JacekGreniger/fpga-sdr-platform/boards.jpg

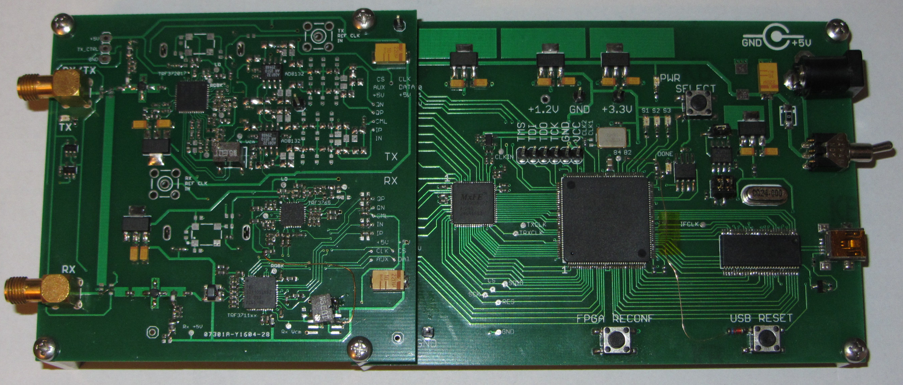
boards.jpg
