JacekGreniger/fpga-sdr-platform/(list of files, cad)

Other CAD files:
fw/USBJmpTb.OBJ
