JacekGreniger/fpga-sdr-platform/hw/fsdr.brd

## EAGLE design hw/fsdr.brd (2014-01-04)

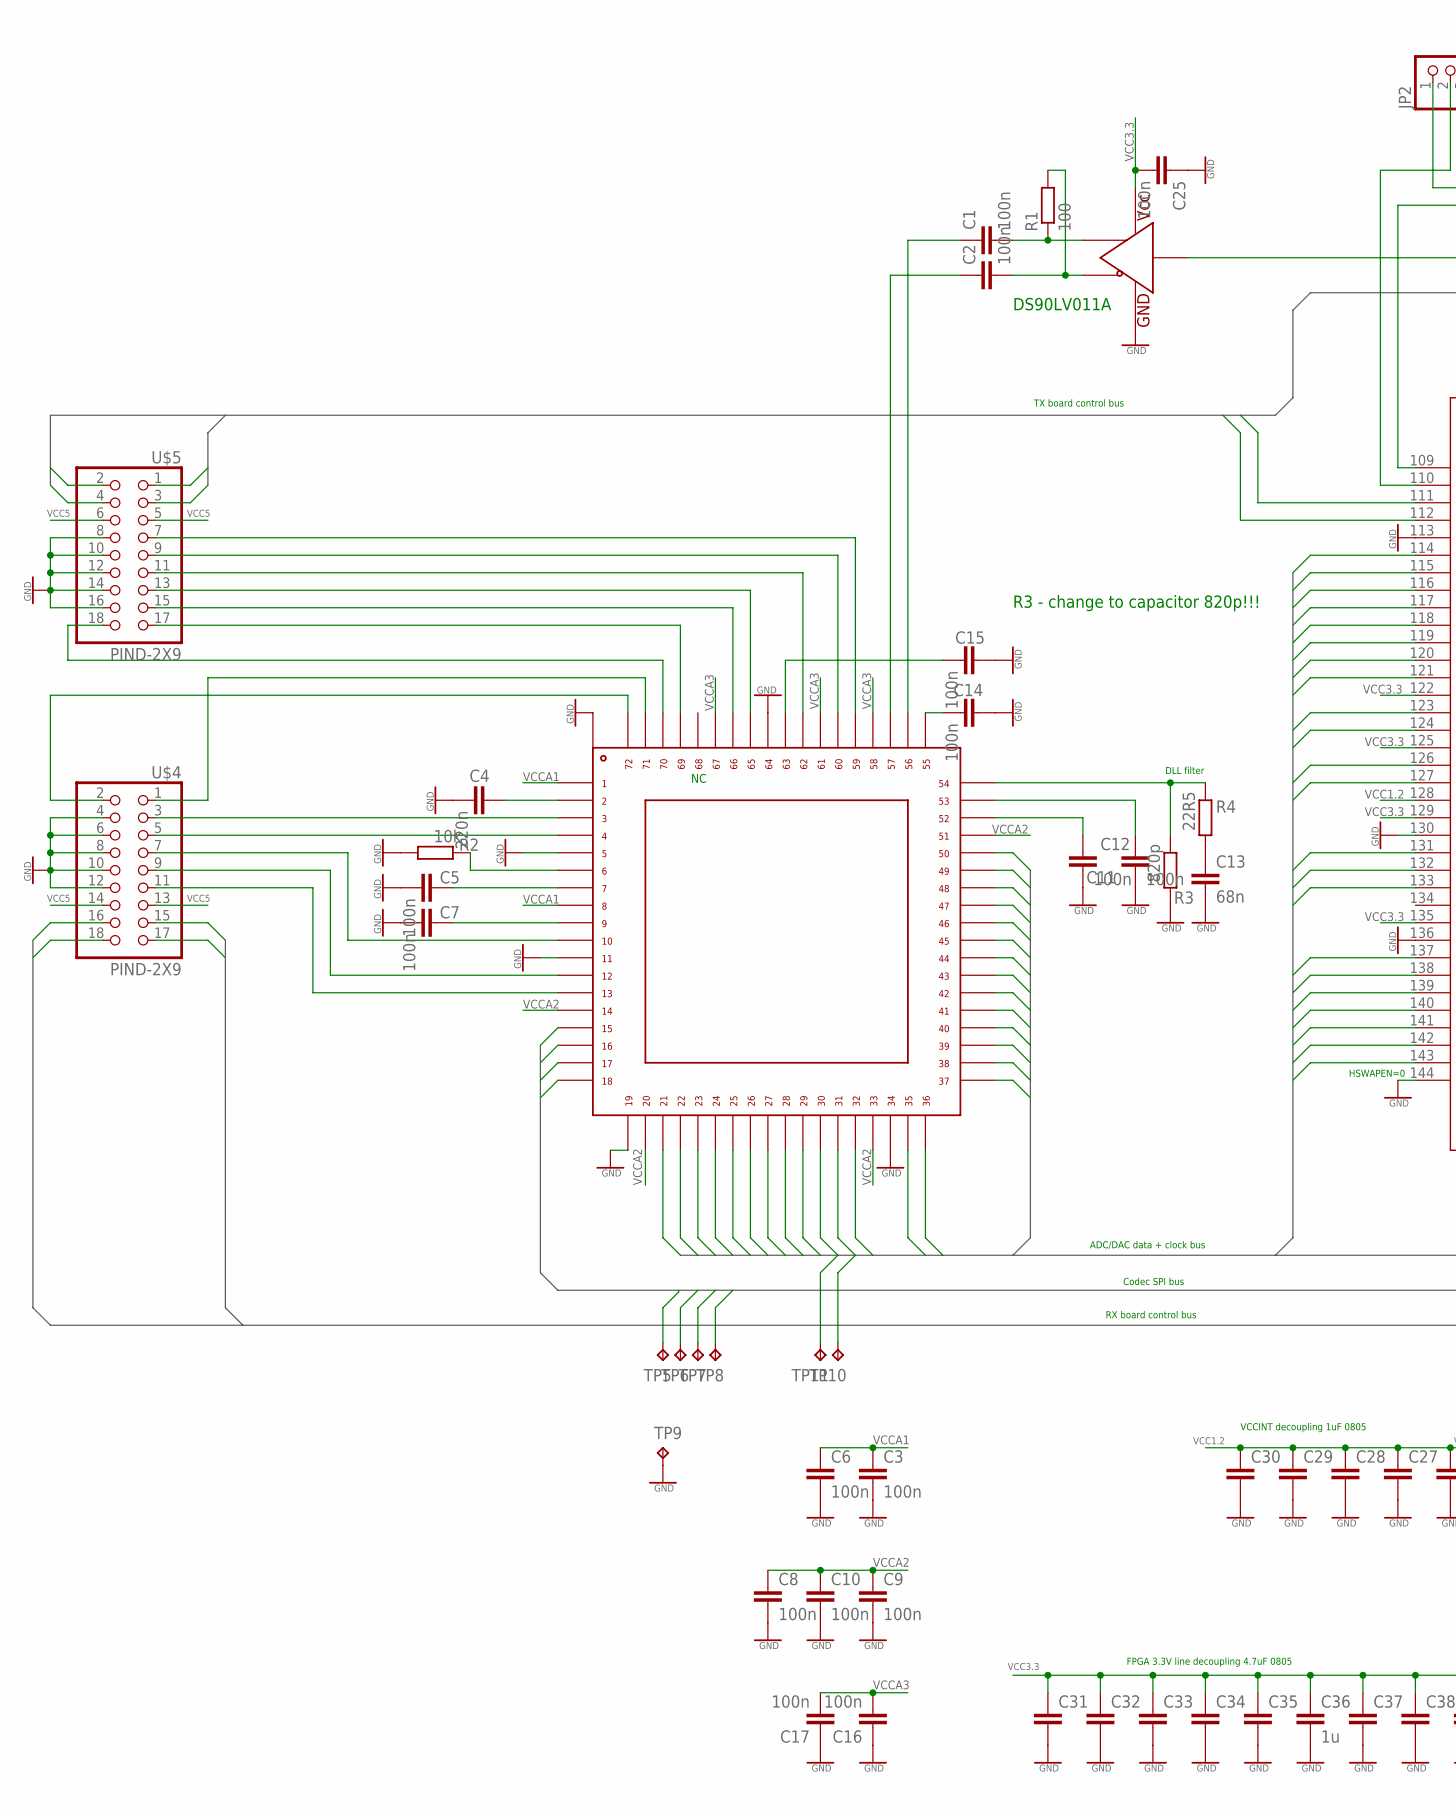
[picture p2: schematic fsdr.sch, sheet 1, part in row 1, column 1]

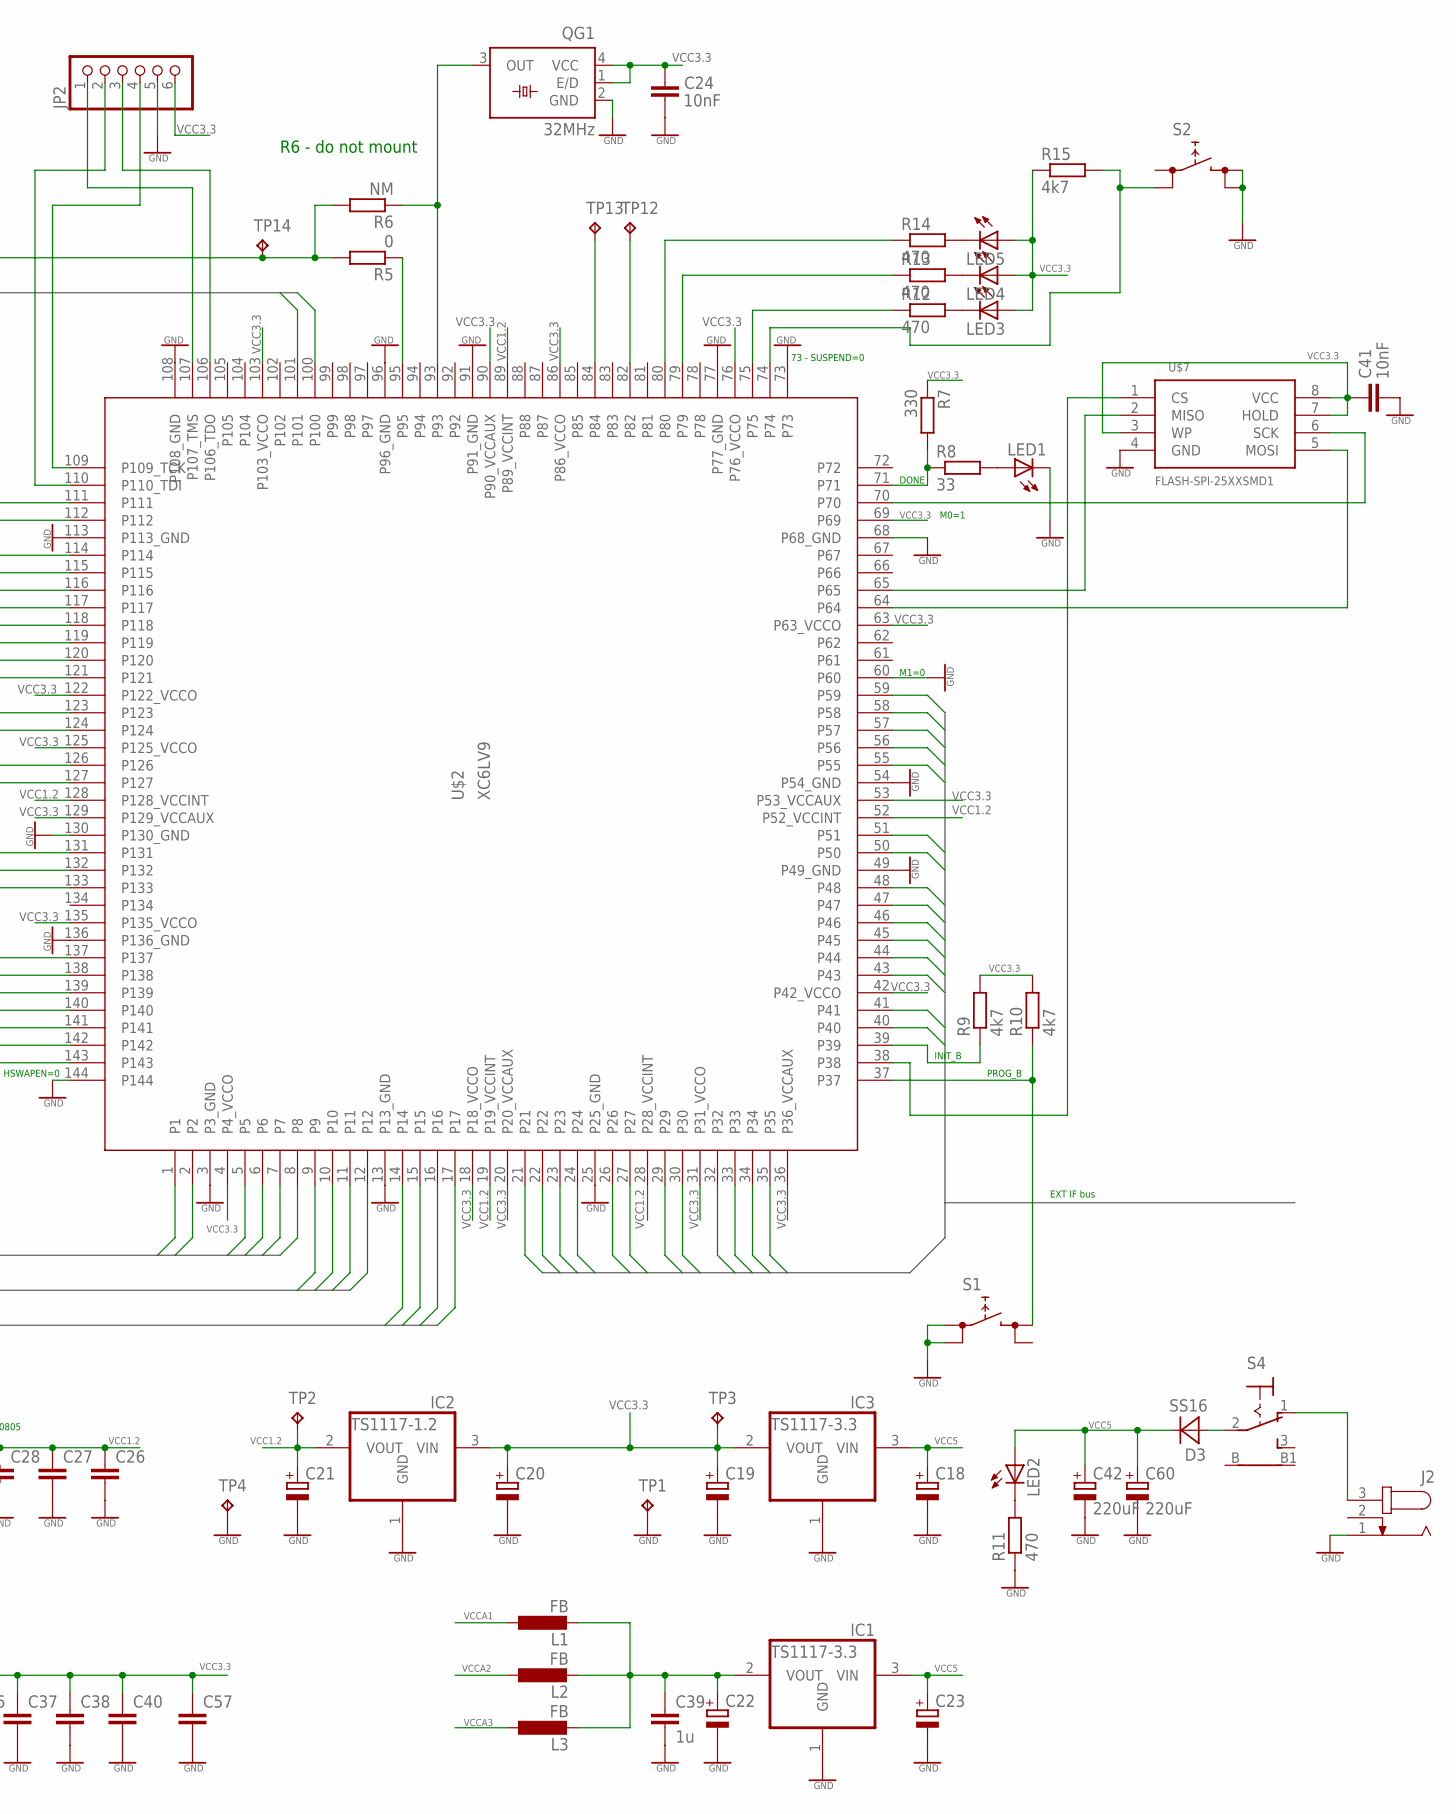
[picture p3: schematic fsdr.sch, sheet 1, part in row 1, column 2]

Parts:
C1, C2, C3, C5, C6, C7, C8, C9, C10, C11, C12, C14, C15, C16, C17, C25: 100n; C0402
C4: 220n; C0402
C13: 68n; C0402
C18, C19, C20, C21, C22, C23: CPOL-EUSMCA; SMC_A
C24, C41: 10nF; C0402
C26, C27, C28, C29, C30, C31, C32, C33, C34, C35, C37, C38, C40, C57: C-EUC0805; C0805
C36, C39: 1u; C0805
C42, C60: 220uF; SMC_D
D3: SS16; SMA
IC1, IC3: TS1117-3.3; SOT223
IC2: TS1117-1.2; SOT223
J2: JACK-PLUG; SPC4078-NOSLOT
JP2: PINHD-1X6; 1X06
L1, L2, L3: FB; C0603
LED1, LED2, LED3, LED4, LED5: LEDSML0805; SML0805
QG1: 32MHz; SM77H
R1: 100; R0402
R2: 10k; R0402
R3: 820p; R0402
R4: 22R5; R0402
R5: 0; R0402
R6: NM; R0402
R7: 330; R0402
R8: 33; R0402
R9, R10, R15: 4k7; R0402
R11, R12, R13, R14: 470; R0402
S1, S2: SKHMPSE010; SKHMPXE010
S4: 9070-1W
TP1, TP2, TP3, TP4: TPPAD1-13; P1-13
TP5, TP6, TP7, TP8, TP9, TP10, TP11, TP12, TP13, TP14: TPB1,27; B1,27
U$1: AD9963; LFCSP72
U$2: XC6LV9; TQFP144
U$3: DS90LV011a; SOT23-5L
U$4, U$5: PIND-2X9; 2X9SMD
U$7: FLASH-SPI-25XXSMD1; SO08-EIAJ

Connections:
CS: TP7.TP, U$1.P$17, U$2.10
GND: C3.2, C4.2, C5.2, C6.2, C7.2, C8.2, C9.2, C10.2, C11.2, C12.2, C13.2, C14.1, C15.1, C16.1, C17.1, C18.-, C19.-, C20.-, C21.-, C22.-, C23.-, C24.1, C25.1, C26.2, C27.2, C28.2, C29.2, C30.2, C31.2, C32.2, C33.2, C34.2, C35.2, C36.2, C37.2, C38.2, C39.2, C40.2, C41.1, C42.-, C57.2, C60.-, IC1.1 (GND), IC2.1 (GND), IC3.1 (GND), J2.1, JP2.5, LED1.C, QG1.2 (GND), R2.2, R3.2, R11.1, S1.1 (1.1), S1.2 (1.2), S2.3 (2.1), S2.4 (2.2), TP1.TP, TP4.TP, TP9.TP, U$1.P$5, U$1.P$11, U$1.P$19, U$1.P$34, U$1.P$64, U$1.P$73_PAD, U$2.3 (P3_GND), U$2.13 (P13_GND), U$2.25 (P25_GND), U$2.49 (P49_GND), U$2.54 (P54_GND), U$2.60, U$2.68 (P68_GND), U$2.73, U$2.77 (P77_GND), U$2.91 (P91_GND), U$2.96 (P96_GND), U$2.108 (P108_GND), U$2.113 (P113_GND), U$2.130 (P130_GND), U$2.136 (P136_GND), U$2.144, U$3.2 (GND), U$4.4, U$4.6, U$4.8, U$4.10, U$4.12, U$5.8, U$5.10, U$5.12, U$5.14, U$5.16, U$7.4 (GND); also elsewhere on the board
unnamed: R7.2, R8.1, U$2.71
unnamed: QG1.3 (OUT), R6.1, U$2.93
unnamed: LED1.A, R8.2
unnamed: JP2.1, U$2.107 (P107_TMS)
unnamed: JP2.3, U$2.106 (P106_TDO)
unnamed: JP2.4, U$2.109 (P109_TCK)
unnamed: JP2.2, U$2.110 (P110_TDI)
unnamed: R10.1, S1.3 (2.1), U$2.37
unnamed: U$1.P$3, U$4.3
unnamed: U$1.P$4, U$4.5
unnamed: U$1.P$10, U$4.7
unnamed: U$1.P$12, U$4.9
unnamed: C7.1, U$1.P$9
unnamed: U$1.P$72, U$4.2
unnamed: U$1.P$71, U$4.1
unnamed: U$1.P$70, U$5.18
unnamed: U$1.P$69, U$5.17
unnamed: U$1.P$66, U$5.15
unnamed: U$1.P$65, U$5.13
unnamed: U$1.P$62, U$5.11
unnamed: U$1.P$60, U$5.9
unnamed: U$1.P$59, U$5.7
unnamed: C1.2, R1.1, U$3.4 (OUT)
unnamed: C2.2, R1.2, U$3.3 (/OUT)
unnamed: C2.1, U$1.P$57
unnamed: C13.1, R4.2
unnamed: C1.1, U$1.P$56
unnamed: R9.1, U$2.39
unnamed: U$1.P$13, U$4.11
unnamed: R2.1, U$1.P$6
unnamed: C5.1, U$1.P$7
unnamed: C4.1, U$1.P$2
unnamed: C14.2, U$1.P$55
unnamed: C15.2, U$1.P$63
unnamed: R3.1, R4.1, U$1.P$54
unnamed: C12.1, U$1.P$53
unnamed: C11.1, U$1.P$52
unnamed: R5.2, R6.2, TP14.TP, U$3.5 (IN)
unnamed: R5.1, U$2.95
unnamed: TP12.TP, U$2.82
unnamed: TP13.TP, U$2.84
unnamed: D3.A, S4.2
unnamed: LED2.C, R11.2
unnamed: C22.+, C39.1, IC1.2 (VOUT), L1.2, L2.2, L3.2
unnamed: J2.3, S4.1 (O)
unnamed: U$2.38, U$7.1 (CS)
unnamed: U$2.64, U$7.5 (MOSI)
unnamed: U$2.70, U$7.6 (SCK)
unnamed: U$2.65, U$7.2 (MISO)
unnamed: R12.1, U$2.75
unnamed: LED3.C, R12.2
unnamed: LED4.C, R13.2
unnamed: LED5.C, R14.2
unnamed: R13.1, U$2.79
unnamed: R14.1, U$2.80
unnamed: R15.2, S2.2 (1.2), U$2.74
P14: U$2.14, U$4.16
P15: U$2.15, U$4.15
P16: U$2.16, U$4.18
P17: U$2.17, U$4.17
P21: U$2.21; also elsewhere on the board
P22: U$2.22; also elsewhere on the board
P23: U$2.23; also elsewhere on the board
P24: U$2.24; also elsewhere on the board
P26: U$2.26; also elsewhere on the board
P27: U$2.27; also elsewhere on the board
P29: U$2.29; also elsewhere on the board
P30: U$2.30; also elsewhere on the board
P32: U$2.32; also elsewhere on the board
P33: U$2.33; also elsewhere on the board
P34: U$2.34; also elsewhere on the board
P35: U$2.35; also elsewhere on the board
P40: U$2.40; also elsewhere on the board
P41: U$2.41; also elsewhere on the board
P43: U$2.43; also elsewhere on the board
P44: U$2.44; also elsewhere on the board
P45: U$2.45; also elsewhere on the board
P46: U$2.46; also elsewhere on the board
P47: U$2.47; also elsewhere on the board
P48: U$2.48; also elsewhere on the board
P50: U$2.50; also elsewhere on the board
P51: U$2.51; also elsewhere on the board
P55: U$2.55; also elsewhere on the board
P56: U$2.56; also elsewhere on the board
P57: U$2.57; also elsewhere on the board
P58: U$2.58; also elsewhere on the board
P59: U$2.59; also elsewhere on the board
P61: U$2.61
P85: U$2.85
P88: U$2.88
P98: U$2.98
P100: U$2.100, U$5.2
P101: U$2.101, U$5.1
P111: U$2.111, U$5.4
P112: U$2.112, U$5.3
RES: TP5.TP, U$1.P$15, U$2.12
SCK: TP6.TP, U$1.P$16, U$2.11
SD: TP8.TP, U$1.P$18, U$2.9
TRXCLK: TP11.TP, U$1.P$36, U$2.133
TRXD0: U$1.P$32, U$2.138
TRXD1: U$1.P$31, U$2.139
TRXD2: U$1.P$30, U$2.140
TRXD3: U$1.P$29, U$2.141
TRXD4: U$1.P$28, U$2.142
TRXD5: U$1.P$27, U$2.143
TRXD6: U$1.P$26, U$2.1
TRXD7: U$1.P$25, U$2.2
TRXD8: U$1.P$24, U$2.5
TRXD9: U$1.P$23, U$2.6
TRXD10: U$1.P$22, U$2.7
TRXD11: U$1.P$21, U$2.8
TRXIQ: U$1.P$35, U$2.137
TXCLK: TP10.TP, U$1.P$37, U$2.132
TXD0: U$1.P$50, U$2.114
TXD1: U$1.P$49, U$2.115
TXD2: U$1.P$48, U$2.116
TXD3: U$1.P$47, U$2.117
TXD4: U$1.P$46, U$2.118
TXD5: U$1.P$45, U$2.119
TXD6: U$1.P$44, U$2.120
TXD7: U$1.P$43, U$2.121
TXD8: U$1.P$42, U$2.123
TXD9: U$1.P$41, U$2.124
TXD10: U$1.P$40, U$2.126
TXD11: U$1.P$39, U$2.127
TXIQ: U$1.P$38, U$2.131
VCC1.2: C21.+, C26.1, C27.1, C28.1, C29.1, C30.1, IC2.2 (VOUT), TP2.TP, U$2.19 (P19_VCCINT), U$2.28 (P28_VCCINT), U$2.52 (P52_VCCINT), U$2.89 (P89_VCCINT), U$2.128 (P128_VCCINT)
VCC3.3: C19.+, C20.+, C24.2, C25.2, C31.1, C32.1, C33.1, C34.1, C35.1, C36.1, C37.1, C38.1, C40.1, C41.2, C57.1, IC2.3 (VIN), IC3.2 (VOUT), JP2.6, LED3.A, LED4.A, LED5.A, QG1.1 (E/D), QG1.4 (VCC), R7.1, R9.2, R10.2, R15.1, TP3.TP, U$2.4 (P4_VCCO), U$2.18 (P18_VCCO), U$2.20 (P20_VCCAUX), U$2.31 (P31_VCCO), U$2.36 (P36_VCCAUX), U$2.42 (P42_VCCO), U$2.53 (P53_VCCAUX), U$2.63 (P63_VCCO), U$2.69, U$2.76 (P76_VCCO), U$2.86 (P86_VCCO), U$2.90 (P90_VCCAUX), U$2.103 (P103_VCCO), U$2.122 (P122_VCCO), U$2.125 (P125_VCCO), U$2.129 (P129_VCCAUX), U$2.135 (P135_VCCO), U$3.1 (VCC), U$7.3 (WP), U$7.7 (HOLD), U$7.8 (VCC)
VCC5: C18.+, C23.+, C42.+, C60.+, D3.C, IC1.3 (VIN), IC3.3 (VIN), LED2.A, U$4.13, U$4.14, U$5.5, U$5.6; also elsewhere on the board
VCCA1: C3.1, C6.1, L1.1, U$1.P$1, U$1.P$8
VCCA2: C8.1, C9.1, C10.1, L2.1, U$1.P$14, U$1.P$20, U$1.P$33, U$1.P$51
VCCA3: C16.2, C17.2, L3.1, U$1.P$58, U$1.P$61, U$1.P$67

Notes on the sheet:
VCCINT decoupling 1uF 0805
HSWAPEN=0
73 - SUSPEND=0
DONE
M1=0
M0=1
PROG_B
INIT_B
FPGA 3.3V line decoupling 4.7uF 0805
Codec SPI bus
RX board control bus
ADC/DAC data + clock bus
DLL filter
TX board control bus
EXT IF bus
R3 - change to capacitor 820p!!!
R6 - do not mount
DS90LV011A

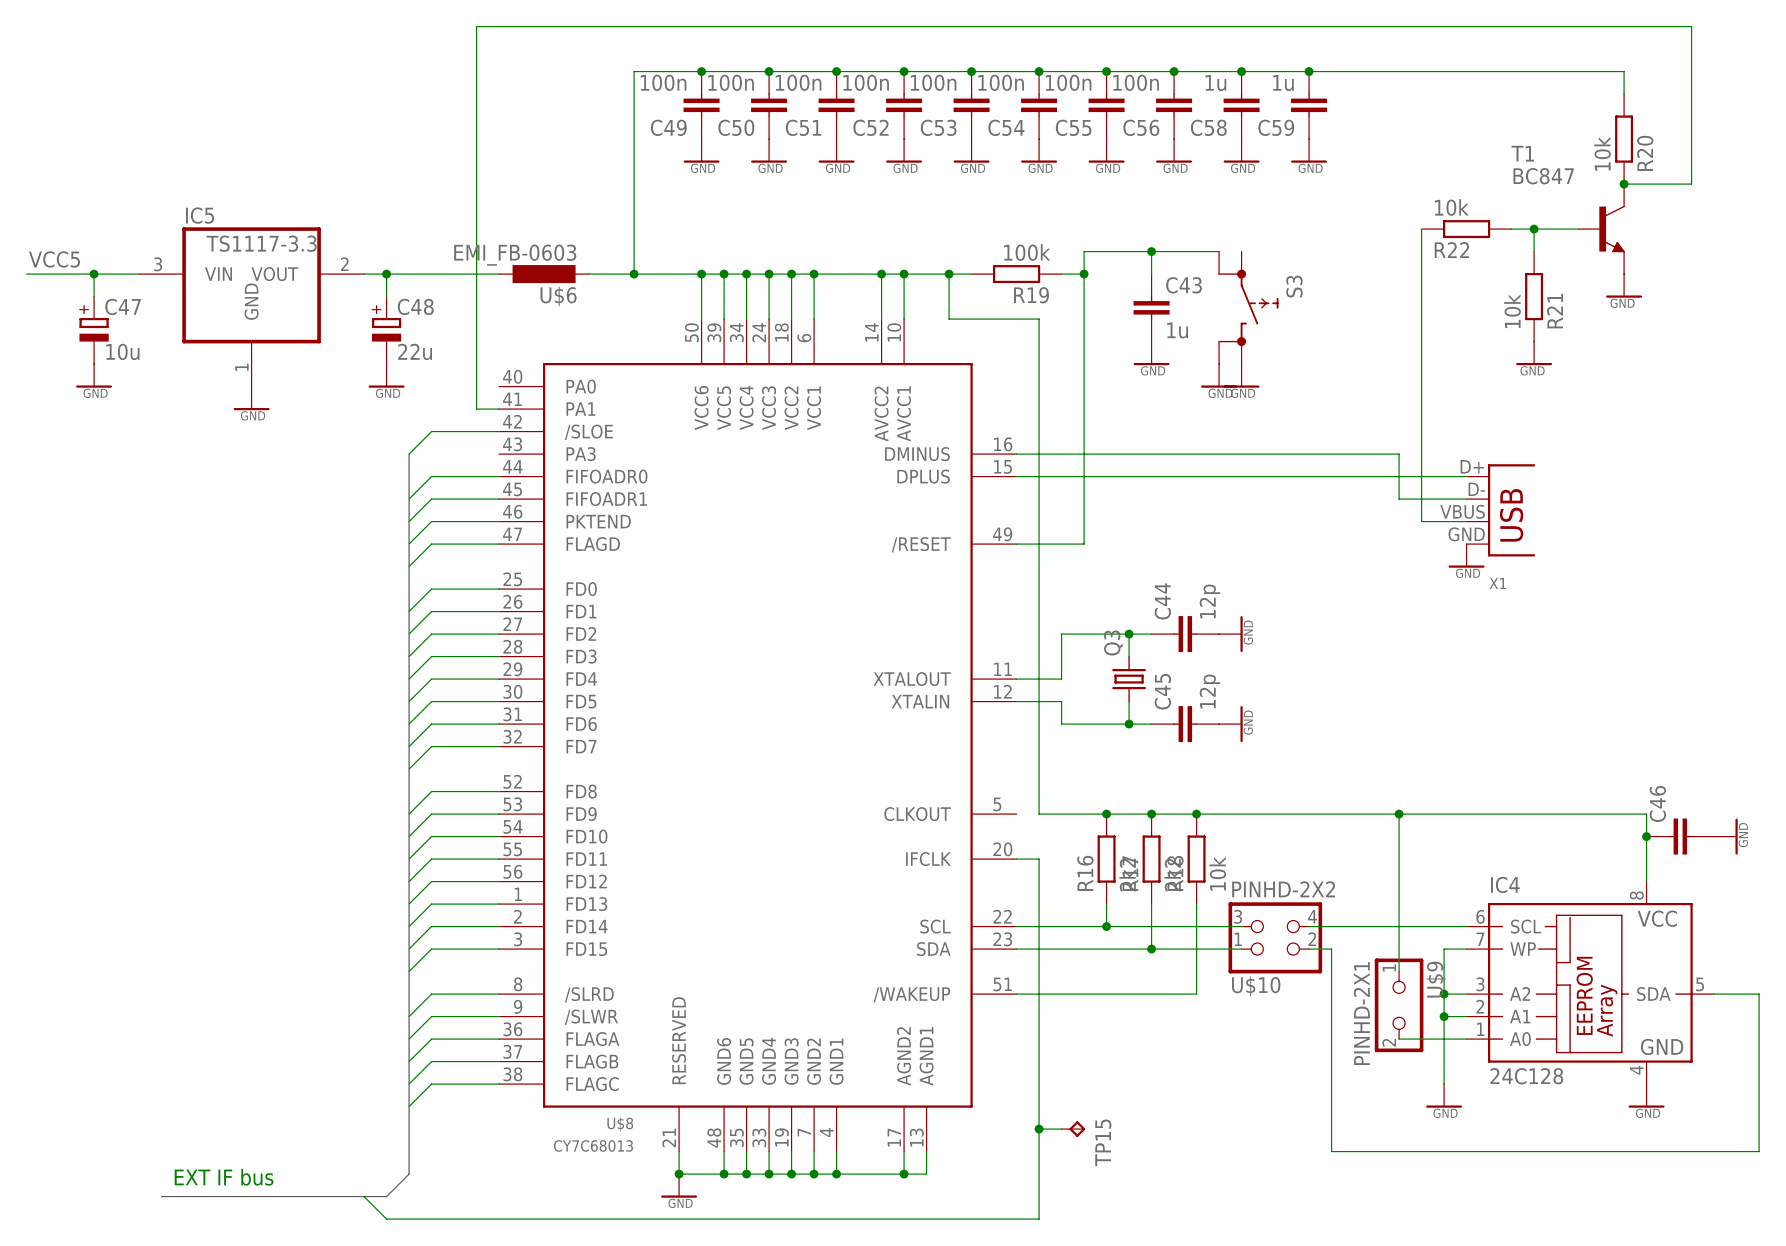
[picture p4: schematic fsdr.sch, sheet 2]

Parts:
C43, C58, C59: 1u; C0402
C44, C45: 12p; C0402
C46: C-EUC0402; C0402
C47: 10u; SMC_A
C48: 22u; SMC_A
C49, C50, C51, C52, C53, C54, C55, C56: 100n; C0402
IC4: 24C128; SO-08
IC5: TS1117-3.3; SOT223
Q3: CRYSTALHC49U-V; HC49U-V
R16, R17: 2k2; R0402
R18, R20, R21, R22: 10k; R0402
R19: 100k; R0402
S3: SKHMPSE010; SKHMPXE010
T1: BC847; SOT23
TP15: TPB1,27; B1,27
U$6: EMI_FB-0603; C0603
U$8: CY7C68013; 56-SSOP
U$9: PINHD-2X1; 2X1SMD
U$10: PINHD-2X2; 2X2SMD
X1: USB-MB-S

Connections:
GND: C43.2, C44.2, C45.2, C46.2, C47.-, C48.-, C49.1, C50.1, C51.1, C52.1, C53.1, C54.1, C55.1, C56.1, C58.1, C59.1, IC4.2 (A1), IC4.3 (A2), IC4.4 (GND), IC4.7 (WP), IC5.1 (GND), R21.1, S3.3 (2.1), S3.4 (2.2), T1.2 (E), U$8.4 (GND1), U$8.7 (GND2), U$8.13 (AGND1), U$8.17 (AGND2), U$8.19 (GND3), U$8.21 (RESERVED), U$8.33 (GND4), U$8.35 (GND5), U$8.48 (GND6), X1.GND; also elsewhere on the board
unnamed: U$8.15 (DPLUS), X1.D+
unnamed: U$8.16 (DMINUS), X1.D-
unnamed: C43.1, R19.1, S3.2 (1.2), U$8.49 (/RESET)
unnamed: R16.1, U$8.22 (SCL), U$10.3
unnamed: IC4.5 (SDA), U$10.2
unnamed: R18.1, U$8.51 (/WAKEUP)
unnamed: C44.1, Q3.2, U$8.11 (XTALOUT)
unnamed: C45.1, Q3.1, U$8.12 (XTALIN)
unnamed: C46.1, C49.2, C50.2, C51.2, C52.2, C53.2, C54.2, C55.2, C56.2, C58.2, C59.2, IC4.8 (VCC), R16.2, R17.2, R18.2, R19.2, R20.2, U$6.2, U$8.6 (VCC1), U$8.10 (AVCC1), U$8.14 (AVCC2), U$8.18 (VCC2), U$8.24 (VCC3), U$8.34 (VCC4), U$8.39 (VCC5), U$8.50 (VCC6), U$9.1
unnamed: IC4.1 (A0), U$9.2
unnamed: C48.+, IC5.2 (VOUT), U$6.1
unnamed: R22.1, X1.VBUS
unnamed: R17.1, U$8.23 (SDA), U$10.1
unnamed: IC4.6 (SCL), U$10.4
unnamed: R20.1, T1.3 (C), U$8.41 (PA1)
unnamed: R21.2, R22.2, T1.1 (B)
P21: U$8.56 (FD12); also elsewhere on the board
P22: U$8.55 (FD11); also elsewhere on the board
P23: U$8.54 (FD10); also elsewhere on the board
P24: U$8.53 (FD9); also elsewhere on the board
P26: U$8.52 (FD8); also elsewhere on the board
P27: U$8.47 (FLAGD); also elsewhere on the board
P29: U$8.46 (PKTEND); also elsewhere on the board
P30: U$8.45 (FIFOADR1); also elsewhere on the board
P32: U$8.44 (FIFOADR0); also elsewhere on the board
P33: U$8.42 (/SLOE); also elsewhere on the board
P34: U$8.38 (FLAGC); also elsewhere on the board
P35: U$8.37 (FLAGB); also elsewhere on the board
P40: U$8.29 (FD4); also elsewhere on the board
P41: U$8.30 (FD5); also elsewhere on the board
P43: U$8.31 (FD6); also elsewhere on the board
P44: U$8.32 (FD7); also elsewhere on the board
P45: U$8.36 (FLAGA); also elsewhere on the board
P46: U$8.27 (FD2); also elsewhere on the board
P47: U$8.28 (FD3); also elsewhere on the board
P48: U$8.26 (FD1); also elsewhere on the board
P50: U$8.25 (FD0); also elsewhere on the board
P51: TP15.TP, U$8.20 (IFCLK); also elsewhere on the board
P55: U$8.9 (/SLWR); also elsewhere on the board
P56: U$8.8 (/SLRD); also elsewhere on the board
P57: U$8.3 (FD15); also elsewhere on the board
P58: U$8.2 (FD14); also elsewhere on the board
P59: U$8.1 (FD13); also elsewhere on the board
VCC5: C47.+, IC5.3 (VIN); also elsewhere on the board

Notes on the sheet:
EXT IF bus

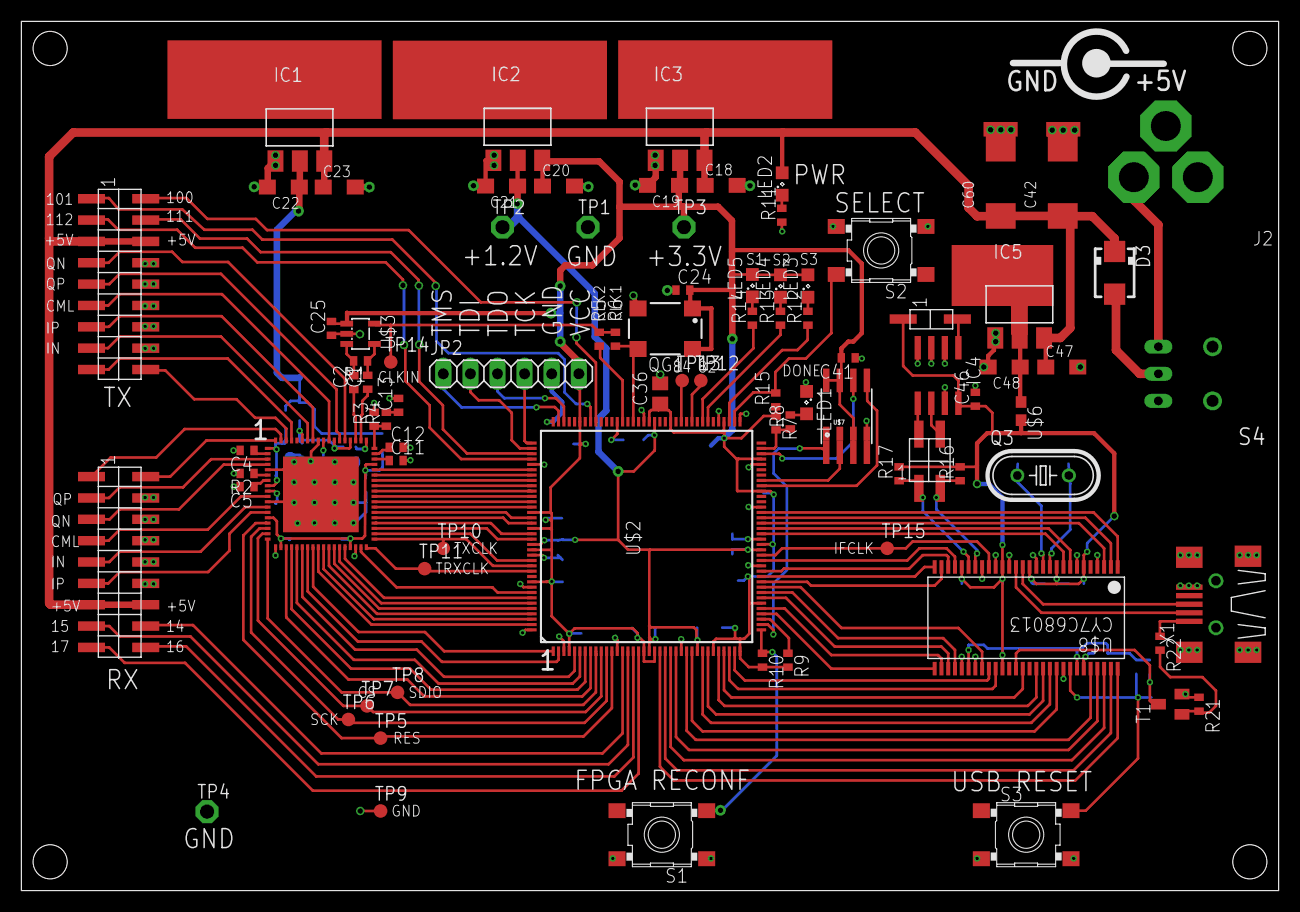
[picture p5: board fsdr.brd from above]

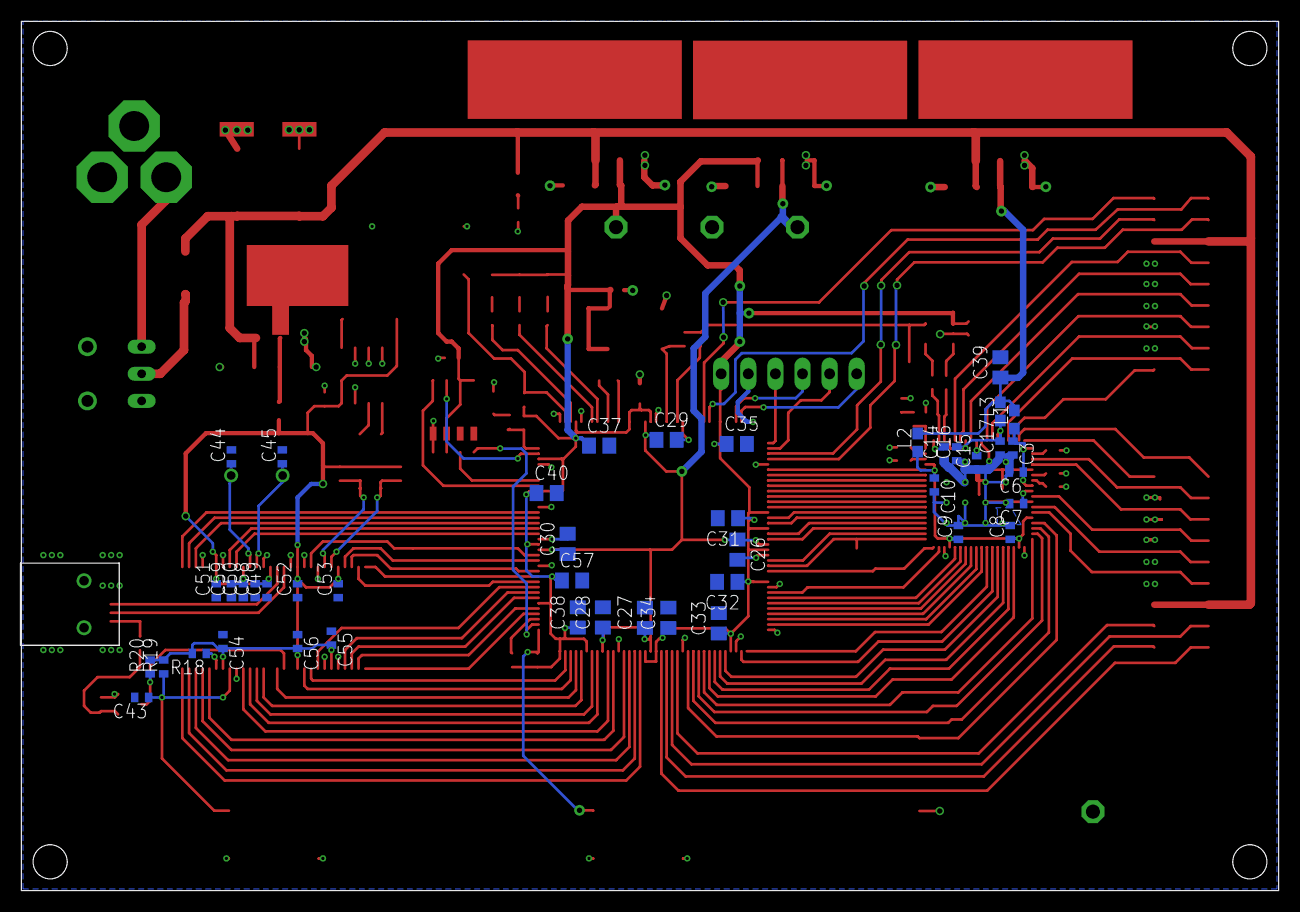
[picture p6: board fsdr.brd from below]

Board: 2 copper layers, 117.8 x 81.4 mm, 131 parts (44 on the bottom side), 146 nets.
