JacekGreniger/fpga-sdr-platform/fw/slave.c

#pragma NOIV                    // Do not generate interrupt vectors
//-----------------------------------------------------------------------------
//   File:      slave.c
//   Contents:  Hooks required to implement USB peripheral function.
//              Code written for FX2 REVE 56-pin and above.
//              This firmware is used to demonstrate FX2 Slave FIF
//              operation.
//   Copyright (c) 2003 Cypress Semiconductor All rights reserved
//-----------------------------------------------------------------------------
#include "fx2.h"
#include "fx2regs.h"
#include "fx2sdly.h"            // SYNCDELAY macro
#include "fsdr.h"

extern BOOL GotSUD;             // Received setup data flag
extern BOOL Sleep;
extern BOOL Rwuen;
extern BOOL Selfpwr;

BYTE Configuration;             // Current configuration
BYTE AlternateSetting;          // Alternate settings

//static WORD xdata LED_Count = 0;

// EZUSB FX2 PORTA = slave fifo enable(s), when IFCFG[1:0]=11
//sbit PA0 = IOA ^ 0;             // alt. func., INT0#
//sbit PA1 = IOA ^ 1;             // alt. func., INT1#
// sbit PA2 = IOA ^ 2;          // is SLOE
//sbit PA3 = IOA ^ 3;             // alt. func., WU2
// sbit PA4 = IOA ^ 4;          // is FIFOADR0
// sbit PA5 = IOA ^ 5;          // is FIFOADR1
// sbit PA6 = IOA ^ 6;          // is PKTEND
// sbit PA7 = IOA ^ 7;          // is FLAGD

// EZUSB FX2 PORTB = FD[7:0], when IFCFG[1:0]=11
// sbit PB0 = IOB ^ 0;
// sbit PB1 = IOB ^ 1;
// sbit PB2 = IOB ^ 2;
// sbit PB3 = IOB ^ 3;
// sbit PB4 = IOB ^ 4;
// sbit PB5 = IOB ^ 5;
// sbit PB6 = IOB ^ 6;
// sbit PB7 = IOB ^ 7;

// EZUSB FX2 PORTD = FD[15:8], when IFCFG[1:0]=11 and WORDWIDE=1
//sbit PD0 = IOD ^ 0;
//sbit PD1 = IOD ^ 1;
//sbit PD2 = IOD ^ 2;
//sbit PD3 = IOD ^ 3;
//sbit PD4 = IOD ^ 4;
//sbit PD5 = IOD ^ 5;
//sbit PD6 = IOD ^ 6;
//sbit PD7 = IOD ^ 7;


BOOL Header_insert = FALSE; // insert header

//-----------------------------------------------------------------------------
// Task Dispatcher hooks
//   The following hooks are called by the task dispatcher.
//-----------------------------------------------------------------------------
void TD_Init( void )
{ 
  CPUCS = 0x12; // CLKSPD[1:0]=10, for 48MHz operation, output CLKOUT driven
 
//  IFCONFIG = 0xE3; // for sync, internal clk, driving IFCLK

  IFCONFIG = 0x03; // use IFCLK pin driven by external logic (5MHz to 48MHz)
// use slave FIFO interface pins driven sync by external master

  // 7 - IFCLKSRC=1   , FIFOs executes on internal clk source 
  // 6 - xMHz=1       , 48MHz operation
  // 5 - IFCLKOE=1    ,Drive IFCLK pin signal at 48MHz
  // 4 - IFCLKPOL=0   , Don't invert IFCLK pin signal from internal clk
  // 3 - ASYNC=0      , master samples synchronous
  // 2 - GSTATE=0     , Don't drive GPIF states out on PORTE[2:0], debug WF
  // 1,0 - IFCFG[1:0]=11, FX2 in slave FIFO mode


  PINFLAGSAB = 0x98; // FLAGA - EP2 Empty flag, FLAGB - EP4 EF
  SYNCDELAY; 
  PINFLAGSCD = 0xEF; // FLAGD - EP6 FULL flag, FLAGC - EP8 FF
  SYNCDELAY; 
  PORTACFG |= 0x80; //PA7 as alternative pin - FLAGD

  // EP2 512 BULK OUT 2x
  SYNCDELAY;                    // see TRM section 15.14
  EP2CFG = 0xA2;                // BUF[1:0]=10 for 2x buffering
  
  // EP6 512 BULK IN 2x
  SYNCDELAY;                    // 
  EP6CFG = 0xE2;                // BUF[1:0]=10 for 2x buffering
  
  // EP4 512 BULK OUT 2x
  SYNCDELAY;                    // see TRM section 15.14
  EP4CFG = 0xA0;                // BUF[1:0]=00 for 4x buffering
  
  // EP6 512 BULK IN 2x
  SYNCDELAY;                    // 
  EP8CFG = 0xE0;                // BUF[1:0]=00 for 4x buffering
  

  SYNCDELAY;
  FIFORESET = 0x80;             // activate NAK-ALL to avoid race conditions
  SYNCDELAY;                    // see TRM section 15.14
  FIFORESET = 0x02;             // reset, FIFO 2
  SYNCDELAY;                    // 
  FIFORESET = 0x04;             // reset, FIFO 4
  SYNCDELAY;                    // 
  FIFORESET = 0x06;             // reset, FIFO 6
  SYNCDELAY;                    // 
  FIFORESET = 0x08;             // reset, FIFO 8
  SYNCDELAY;                    // 
  FIFORESET = 0x00;             // deactivate NAK-ALL


  // handle the case where we were already in AUTO mode...
  // ...for example: back to back firmware downloads...
  SYNCDELAY;                    // 
  EP2FIFOCFG = 0x00;            // AUTOOUT=0, 8 bit data bus
  
  // core needs to see AUTOOUT=0 to AUTOOUT=1 switch to arm endp's
  
  SYNCDELAY;                    // 
  EP2FIFOCFG = 0x11;            // AUTOOUT=1, 16 bit data bus

  SYNCDELAY;                    // 
  EP4FIFOCFG = 0x11;            // AUTOOUT=1, 16 bit data bus
  
  SYNCDELAY;                    // 
  EP6FIFOCFG = 0x0D;            // AUTOIN=1, ZEROLENIN=1, WORDWIDE=1

  SYNCDELAY;                    // 
  EP8FIFOCFG = 0x0D;            // AUTOIN=1, ZEROLENIN=1, WORDWIDE=1

  SYNCDELAY;
}

void TD_Poll( void )
{ // Called repeatedly while the device is idle

  // ...nothing to do... slave fifo's are in AUTO mode...

  if (PA1) // if VBUS not present (using a PORTA.1 pin for example)
  {
    // take action and set the DISCON bit to disconnect FX2LP from USB
    USBCS |= bmDISCON; // Setting DISCON bit disables the pull up on D+
	PA0 = 0;
  }
  else
  {
    USBCS &= ~bmDISCON; // Clear DISCON
	PA0 = 1;
    // Proceed to do other tasks
  }
}

BOOL TD_Suspend( void )          
{ // Called before the device goes into suspend mode
   return( TRUE );
}

BOOL TD_Resume( void )          
{ // Called after the device resumes
   return( TRUE );
}

//-----------------------------------------------------------------------------
// Device Request hooks
//   The following hooks are called by the end point 0 device request parser.
//-----------------------------------------------------------------------------
BOOL DR_GetDescriptor( void )
{
   return( TRUE );
}

BOOL DR_SetConfiguration( void )   
{ // Called when a Set Configuration command is received
  
  if( EZUSB_HIGHSPEED( ) )
  { // ...FX2 in high speed mode
    EP6AUTOINLENH = 0x02;
    SYNCDELAY;
    EP8AUTOINLENH = 0x02;   // set core AUTO commit len = 512 bytes
    SYNCDELAY;
    EP6AUTOINLENL = 0x00;
    SYNCDELAY;
    EP8AUTOINLENL = 0x00;
  }
  else
  { // ...FX2 in full speed mode
    EP6AUTOINLENH = 0x00;
    SYNCDELAY;
    EP8AUTOINLENH = 0x00;   // set core AUTO commit len = 64 bytes
    SYNCDELAY;
    EP6AUTOINLENL = 0x40;
    SYNCDELAY;
    EP8AUTOINLENL = 0x40;
  }
      
  Configuration = SETUPDAT[ 2 ];
  return( TRUE );        // Handled by user code
}

BOOL DR_GetConfiguration( void )   
{ // Called when a Get Configuration command is received
   EP0BUF[ 0 ] = Configuration;
   EP0BCH = 0;
   EP0BCL = 1;
   return(TRUE);          // Handled by user code
}

BOOL DR_SetInterface( void )       
{ // Called when a Set Interface command is received
   AlternateSetting = SETUPDAT[ 2 ];
   return( TRUE );        // Handled by user code
}

BOOL DR_GetInterface( void )       
{ // Called when a Set Interface command is received
   EP0BUF[ 0 ] = AlternateSetting;
   EP0BCH = 0;
   EP0BCL = 1;
   return( TRUE );        // Handled by user code
}

BOOL DR_GetStatus( void )
{
   return( TRUE );
}

BOOL DR_ClearFeature( void )
{
   return( TRUE );
}

BOOL DR_SetFeature( void )
{
   return( TRUE );
}

#define VX_B7 0xB2
#define VX_B8 0xB3

BOOL DR_VendorCmnd( void )
{
 switch (SETUPDAT[1])
  {
 case VX_B7: // read GPIFTRIG register

			  
		FIFORESET = 0x80;
		SYNCDELAY;
		FIFORESET = 0x02;
		SYNCDELAY;
		FIFORESET = 0x00;
		SYNCDELAY;
		EP0BUF[0] = EP68FIFOFLGS;
		EP0BUF[1] = EP2FIFOBCL;
		EP0BCH = 0;
		EP0BCL = 2;
		EP0CS |= bmHSNAK;	
	
		Header_insert = TRUE;
		break;

	case VX_B8:
		EP0BUF[0] = EP68FIFOFLGS;
		EP0BUF[1] = EP2FIFOBCL;
		EP0BCH = 0;
		EP0BCL = 2;
		EP0CS |= bmHSNAK;	
		break;
   default:
   return( TRUE );
  }
}

//-----------------------------------------------------------------------------
// USB Interrupt Handlers
//   The following functions are called by the USB interrupt jump table.
//-----------------------------------------------------------------------------

// Setup Data Available Interrupt Handler
void ISR_Sudav( void ) interrupt 0
{
   GotSUD = TRUE;         // Set flag
   EZUSB_IRQ_CLEAR( );
   USBIRQ = bmSUDAV;      // Clear SUDAV IRQ
}

// Setup Token Interrupt Handler
void ISR_Sutok( void ) interrupt 0
{
   EZUSB_IRQ_CLEAR( );
   USBIRQ = bmSUTOK;      // Clear SUTOK IRQ
}

void ISR_Sof( void ) interrupt 0
{
   EZUSB_IRQ_CLEAR( );
   USBIRQ = bmSOF;        // Clear SOF IRQ
}

void ISR_Ures( void ) interrupt 0
{
   if ( EZUSB_HIGHSPEED( ) )
   {
      pConfigDscr = pHighSpeedConfigDscr;
      pOtherConfigDscr = pFullSpeedConfigDscr;
   }
   else
   {
      pConfigDscr = pFullSpeedConfigDscr;
      pOtherConfigDscr = pHighSpeedConfigDscr;
   }
   
   EZUSB_IRQ_CLEAR( );
   USBIRQ = bmURES;       // Clear URES IRQ
}

void ISR_Susp( void ) interrupt 0
{
   Sleep = TRUE;
   EZUSB_IRQ_CLEAR( );
   USBIRQ = bmSUSP;
}

void ISR_Highspeed( void ) interrupt 0
{
   if ( EZUSB_HIGHSPEED( ) )
   {
      pConfigDscr = pHighSpeedConfigDscr;
      pOtherConfigDscr = pFullSpeedConfigDscr;
   }
   else
   {
      pConfigDscr = pFullSpeedConfigDscr;
      pOtherConfigDscr = pHighSpeedConfigDscr;
   }

   EZUSB_IRQ_CLEAR( );
   USBIRQ = bmHSGRANT;
}

void ISR_Ep0ack( void ) interrupt 0
{
}
void ISR_Stub( void ) interrupt 0
{
}
void ISR_Ep0in( void ) interrupt 0
{
}
void ISR_Ep0out( void ) interrupt 0
{
}
void ISR_Ep1in( void ) interrupt 0
{
}
void ISR_Ep1out( void ) interrupt 0
{
}
void ISR_Ep2inout( void ) interrupt 0
{
}
void ISR_Ep4inout( void ) interrupt 0
{
}
void ISR_Ep6inout( void ) interrupt 0
{
}
void ISR_Ep8inout( void ) interrupt 0
{
}
void ISR_Ibn( void ) interrupt 0
{
}
void ISR_Ep0pingnak( void ) interrupt 0
{
}
void ISR_Ep1pingnak( void ) interrupt 0
{
}
void ISR_Ep2pingnak( void ) interrupt 0
{
}
void ISR_Ep4pingnak( void ) interrupt 0
{
}
void ISR_Ep6pingnak( void ) interrupt 0
{
}
void ISR_Ep8pingnak( void ) interrupt 0
{
}
void ISR_Errorlimit( void ) interrupt 0
{
}
void ISR_Ep2piderror( void ) interrupt 0
{
}
void ISR_Ep4piderror( void ) interrupt 0
{
}
void ISR_Ep6piderror( void ) interrupt 0
{
}
void ISR_Ep8piderror( void ) interrupt 0
{
}
void ISR_Ep2pflag( void ) interrupt 0
{
}
void ISR_Ep4pflag( void ) interrupt 0
{
}
void ISR_Ep6pflag( void ) interrupt 0
{
}
void ISR_Ep8pflag( void ) interrupt 0
{
}
void ISR_Ep2eflag( void ) interrupt 0
{
}
void ISR_Ep4eflag( void ) interrupt 0
{
}
void ISR_Ep6eflag( void ) interrupt 0
{
}
void ISR_Ep8eflag( void ) interrupt 0
{
}
void ISR_Ep2fflag( void ) interrupt 0
{
}
void ISR_Ep4fflag( void ) interrupt 0
{
}
void ISR_Ep6fflag( void ) interrupt 0
{
}
void ISR_Ep8fflag( void ) interrupt 0
{
}
void ISR_GpifComplete( void ) interrupt 0
{
}
void ISR_GpifWaveform( void ) interrupt 0
{
}
